lauchokyip/ece477grp4/README.md

# ece477grp4 - Virtual Queue
## Team members
* [Nathan Pietraszak](https://github.com/natepzak) (Team Lead)
* [Aidan Connor Roy](https://github.com/aidanroy0) (Hardware Lead)
* [Devansh Rathi](https://github.com/DevanshRathi1) (Software Lead)
* [Chok Yip Lau](https://github.com/lauchokyip) (Systems Lead)

## Web Server
* [link](https://virtualqueue477.herokuapp.com/) to the web server
  
## User manual 
* [link](UserManual.pdf) to the user manual

### Homework 
* [Functional Specification](HW/ECE477HW2.pdf)
* [Software Overview](HW/ECE477HW3.pdf)
* [Component Analysis](HW/ECE477HW4.pdf)
* [Bill of Materials](HW/ECE477HW5.pdf)
* [Electrical Overview](HW/ECE477HW6.pdf)
* [Mechanical Overview](HW/ECE477HW7.pdf)
* [Software Formalization](HW/ECE477HW8.pdf)

### STM32L4 Documentation
* [Programming Manual](programmingManual.pdf)
* [Reference Manual](referenceManual.pdf)

### References
* [STM32L4 Documentation website](https://www.st.com/en/microcontrollers-microprocessors/stm32l476vg.html#documentation)
* [Datasheet for Wifi Module (ESP8266)](refs/ESP8266_Specifications_English.pdf)
* [Datasheet for Motion Detection Sensor (AK9753)](refs/AK9753.pdf)
* [Datasheet for Barcode Scanner (GM65)](refs/DFR0660.pdf)
* [Datasheet for LED Display (YX700WV03)](refs/adafruit_SPEC-YX700WV03_REV.A-787880.pdf)
* [Datasheet for Display Driver (RA8875)](refs/RA8875_DS_V19_Eng.pdf)
* [Datasheet for Battery (ICR18650)](refs/C450_-_ICR18650_6600mAh_3.7V_20140729.pdf)
* [Datasheet for Thermopile (TS305-11C55)](refs/ENG_DS_TS305-11C55_A.pdf)
* [Datasheet for Class-D Amplifier (PAM8302A)](refs/PAM8302A.pdf)
* [Datasheet for Speaker (CES-30207-158L120-67)](refs/ces_30207_158l120_67-1860391.pdf)
* [Datasheet for Low Battery Indicator IC (BD46335G-TR)](refs/bd45xxg-e.pdf)
* [Datasheet for Step-Up Voltage Converter (MAX8815A-1516131)](refs/MAX8815A-1516131.pdf)
* [Datasheet for Step-Down Voltage Converter (MAX8815A-1516131)](refs/tps62080a.pdf)
