lauchokyip/ece477grp4/HW/schematic_draft_v1.sch

## EAGLE design HW/schematic_draft_v1.sch (2021-04-16)

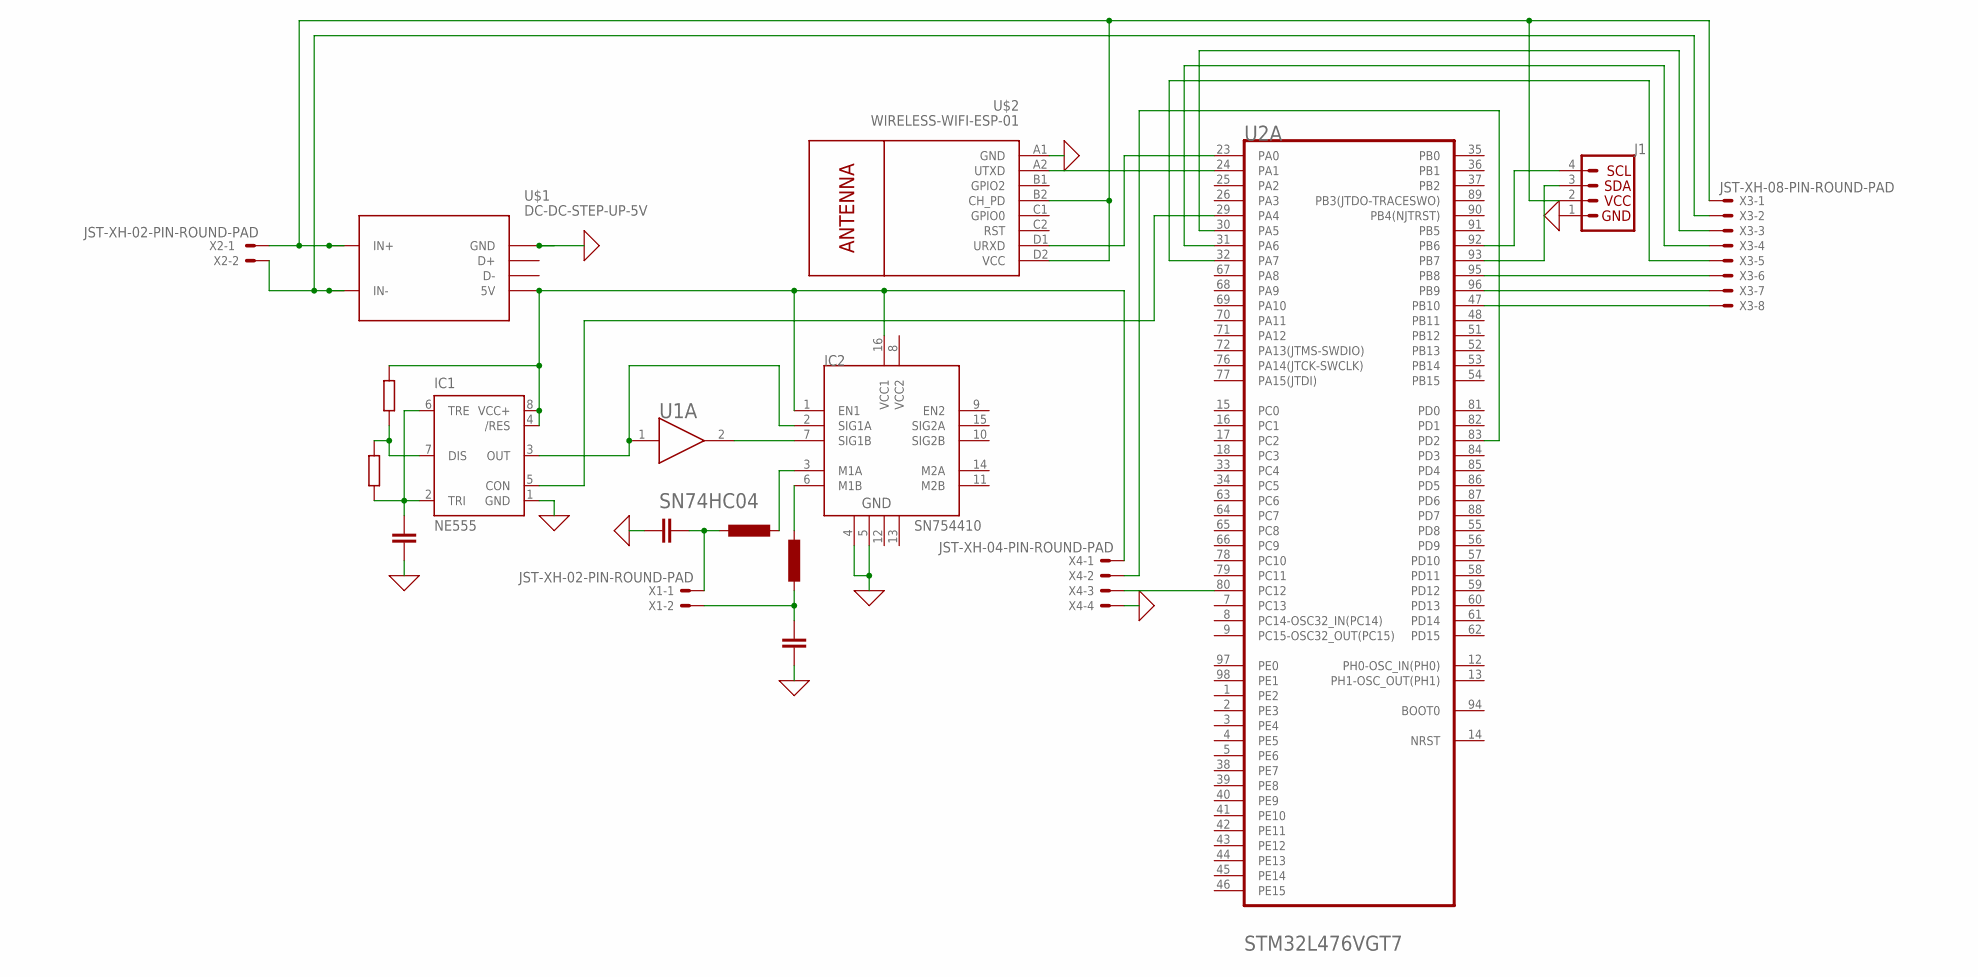
[picture p20: schematic schematic_draft_v1.sch]

Parts:
IC1: NE555; DIL-08
IC2: SN754410; DIP16
J1: QWIIC_CONNECTORJS-1MM; 1X04_1MM_RA
U1: TEXAS_INSTRUMENTS_SN74HC04TEXAS_INSTRUMENTS_SN74H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; TEXAS_INSTRUMENTS_SN74HC04_0
U2: STMICROELECTRONICS_STM32L476VGT7STMICROELECTRONIC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; STMICROELECTRONICS_STM32L476VGT7_0
U$1: DC-DC-STEP-UP-5V
U$2: WIRELESS-WIFI-ESP-01
X1, X2: JST-XH-02-PIN-ROUND-PAD; JST-XH-02-PACKAGE-ROUND-PAD
X3: JST-XH-08-PIN-ROUND-PAD; JST-XH-08-PACKAGE-ROUND-PAD
X4: JST-XH-04-PIN-ROUND-PAD; JST-XH-04-PACKAGE-ROUND-PAD

Connections:
0: IC1.1 (GND), IC2.4, IC2.5, J1.1 (GND), U$1.GND, U$2.A1 (GND), X4.4
unnamed: U2.80 (PC12), X4.3
unnamed: J1.2 (VCC), U$1.IN+, U$2.B2 (CH_PD), U$2.D2 (VCC), X2.1, X3.1
unnamed: U$1.IN-, X2.2, X3.2
unnamed: IC1.2 (TRI), IC1.6 (TRE)
unnamed: J1.4 (SCL), U2.92 (PB6)
unnamed: IC2.7 (SIG1B), U1.2 (!1Y!)
unnamed: IC1.3 (OUT), IC2.2 (SIG1A), U1.1 (1A)
unnamed: U2.24 (PA1), U$2.A2 (UTXD)
unnamed: U2.23 (PA0), U$2.D1 (URXD)
unnamed: IC1.4 (/RES), IC1.8 (VCC+), IC2.1 (EN1), IC2.16 (VCC1), U$1.5V, X4.1
unnamed: J1.3 (SDA), U2.93 (PB7)
unnamed: IC1.5 (CON), U2.29 (PA4)
unnamed: U2.83 (PD2), X4.2
unnamed: U2.30 (PA5), X3.3
unnamed: U2.31 (PA6), X3.4
unnamed: U2.32 (PA7), X3.5
unnamed: U2.95 (PB8), X3.6
unnamed: U2.96 (PB9), X3.7
unnamed: U2.47 (PB10), X3.8
