lauchokyip/ece477grp4/VirtualQueue/Src/main.c

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

/* Includes ------------------------------------------------------------------*/
#include "main.h"

/* USER CODE BEGIN Includes */
#include <stdio.h>
//#include "retarget.h"
#include "utility.h"
#include "wifi_module.h"
#include "qr_scanner.h"
#include "motion.h"
#include "mytype.h"
#include "thermopile.h"
/* USER CODE END Includes */

ADC_HandleTypeDef hadc1;
ADC_HandleTypeDef hadc2;

I2C_HandleTypeDef hi2c1;

LCD_HandleTypeDef hlcd;

SPI_HandleTypeDef hspi1;

TIM_HandleTypeDef htim16;
TIM_HandleTypeDef htim17;

UART_HandleTypeDef huart4;
UART_HandleTypeDef huart2;
DMA_HandleTypeDef hdma_uart4_rx;

void SystemClock_Config(void);
static void MX_GPIO_Init(void);
static void MX_DMA_Init(void);
static void MX_LCD_Init(void);
static void MX_USART2_UART_Init(void);
static void MX_UART4_Init(void);
static void MX_SPI1_Init(void);
static void MX_TIM16_Init(void);
static void MX_ADC1_Init(void);
static void MX_ADC2_Init(void);
static void MX_I2C1_Init(void);
static void MX_TIM17_Init(void);
/**
  * @brief  The application entry point.
  * @retval int
  */
int main(void)
{
  /* MCU Configuration--------------------------------------------------------*/

  /* Reset of all peripherals, Initializes the Flash interface and the Systick. */
  HAL_Init();

  /* USER CODE BEGIN Init */
  BSP_LCD_GLASS_Init();

  /* USER CODE END Init */

  /* Configure the system clock */
  SystemClock_Config();

  /* Initialize all configured peripherals */
  MX_GPIO_Init();
  MX_DMA_Init();
  MX_LCD_Init();
  MX_USART2_UART_Init();
  MX_UART4_Init();
  MX_SPI1_Init();
  MX_TIM16_Init();
  MX_ADC1_Init();
  MX_ADC2_Init();
  MX_I2C1_Init();
  MX_TIM17_Init();
  /* USER CODE BEGIN 2 */
  //RetargetInit(&huart2);
  printf("\r\nStarting\r\n");

  // INITS
  queue_length = 0; // init these first so the display works
  store_capacity = 0;
  num_in_store = 0;

  qr_scanner_init(&huart2, 0); // note - THIS SHOULD BE CALLED BEFORE esp8266_init() if using QR scanning for WiFi setup

  bool esp_ok = esp8266_init(&huart4, &hspi1, 1, 0);
  if (esp_ok == false) {
	  //main_display_info(&hspi1, num_in_store, queue_length, store_capacity, "Wifi doesn't set up properly", NULL, NULL, NULL);
	  return 1;
  }

  //main_display_init(&hspi1);
  main_display_info(&hspi1, num_in_store, queue_length, store_capacity, "Starting up...", "Please wait", NULL, NULL);

  qr_scan_pending = 0;
  HAL_UART_Receive_IT(qr_huart, qr_buf, QR_SIZE); // note - CALL THIS HERE to restart QR scanning after WiFi setup via QR

  thermopile_init(&hadc1, &hadc2);

  bool motion_sensor_ok = initialize_motion_sensor(&hi2c1);
  if (motion_sensor_ok != true) {
	  main_display_info(&hspi1, num_in_store, queue_length, store_capacity, "motion sensor fails", NULL, NULL, NULL);
	  return 1;
  }


  // MOTION SENSOR BUFFER VARIABLES
  int pir_size = 50; // size of buffer
  int pir_samples[pir_size]; // buffer
  int threshold = 5; // number of readings in buffer to trigger motion
  int left = 0; // number of lefts
  int right = 0; // number of rights
  int nothing = pir_size; // number of no motions
  bool send_enable = false; // flag to prevent constantly sending when threshold met
  int sample_i = 0; // sample index
  for(; sample_i < pir_size; ++sample_i) {
	  pir_samples[sample_i] = 0;
  }
  sample_i = 0;

  printf("INIT DONE\r\n");
  main_display_info(&hspi1, num_in_store, queue_length, store_capacity, "Setup complete!", NULL, NULL, NULL);
  //get_status(); // get initial queue status for monitor
  HAL_TIM_Base_Start_IT(&htim16);
  HAL_TIM_Base_Start_IT(&htim17);

  int prevent_strobe = 0;
  /* USER CODE END 2 */

  /* Infinite loop */
  /* USER CODE BEGIN WHILE */
  while (1)
  {

    // QR HANDLING
    // if a qr scan has OCCURRED, handle
	if (qr_scan_pending == 1) {
		printf("BEGIN SEND SCAN\r\n");
		qr_scan_received();
	}

    // MOTION SENSOR HANDLING
	if (loop_motion_sensor(&hi2c1) == true) {
		uint8_t movement = motion_sensor_get_moment();

        // decrement count of motion type that is being overwritten
		if (pir_samples[sample_i] == 1) {
			--right;
		} else if (pir_samples[sample_i] == -1) {
			--left;
		} else {
			--nothing;
		}

        // increase appropriate motion type count
		if (movement & MOVEMENT_FROM_2_TO_4)
	    {
		  // RIGHT
	      pir_samples[sample_i] = 1;
	      ++right;
	    }
	    else if(movement & MOVEMENT_FROM_4_TO_2)
	    {
	      // LEFT
	      pir_samples[sample_i] = -1;
	      ++left;
	    } else {
	      pir_samples[sample_i] = 0;
	      ++nothing;
	    }

		if (sample_i % 10 == 0) {
			printf("left: %d    right: %d    nothing: %d\r\n", left, right, nothing);
			if (nothing != pir_size) {
				int i;
				for (i = 0; i < pir_size; ++i) {
					printf("%d ", pir_samples[i]);
				}
				printf("\r\n");
			}
		}

        // increment buffer index
		sample_i++;
		if (sample_i >= pir_size) {
			sample_i = 0;
		}

        // if motion type has exceeded threshold and able to send,
        // send that type and disable sending
		if (left > threshold && send_enable) {
			printf("SEND LEFT\r\n");
			if (valid_entries > 0) {
				send_entry();
				--valid_entries;
				main_display_info(&hspi1, num_in_store, queue_length, store_capacity, "     Welcome to the ABC Store!", "Please wait to enter...", NULL, NULL);
			} else {
				send_unauthorizedEntry();
				main_display_info(&hspi1, num_in_store, queue_length, store_capacity, "WARNING:", "UNAUTHORIZED ENTRY", NULL, NULL);
			}
			send_enable = false;
		} else if (right > threshold && send_enable) {
			printf("SEND RIGHT\r\n");
			send_exit();
			send_enable = false;
			main_display_info(&hspi1, num_in_store, queue_length, store_capacity, "     Welcome to the ABC Store!", "Please wait to enter...", NULL, NULL);
		} else if (right < threshold && left < threshold) {
            // if both motion types below threshold, enable sending
			if (!send_enable) {
				printf("SEND ENABLE\r\n");
				send_enable = true;
				main_display_info(&hspi1, num_in_store, queue_length, store_capacity, "     Welcome to the ABC Store!", NULL, NULL, NULL);
			}
		}
	}

    // WIFI HANDLING
    // if have a response to handle
	if (message_pending_handling == 1) {
		handle_message_response();
	}
    // if messages pending, get ok and then send
	if (message_queue_head != NULL) {
		if (ready_for_next_message == 1) {
			tcp_connect();
		} else if (good_to_get_ok == 1) {
			get_ok_to_send();
		} else if (good_for_send == 1) {
			send_message();
		}
	}

	// TEMPERATURE
	if (people_checking_in > 0) {
		printf("CHECKING IN\r\n");
		if (prevent_strobe == 0) {
			main_display_info(&hspi1, num_in_store, queue_length, store_capacity, "     Welcome!", "Place your forehead near the sensor", "at the top of the kiosk", NULL);
			HAL_Delay(3000);
			prevent_strobe = 1;
		}
		/*
		//temeprature test
		while(1){
			int temp = getTemp();
			char temp_str[4];
			sprintf(temp_str, "%d", temp);

//purposeful Tsen manipulation
			int Tsen = getTsen();
			Tsen = 30;
			char temp_str2[4];
			sprintf(temp_str2, "%d", Tsen);

			int thermopileV = getV();
			char temp_str3[4];
			sprintf(temp_str3, "%d", thermopileV);

			int Rsen = getR();
			char temp_str4[4];
			sprintf(temp_str4, "%d", Rsen);

			HAL_Delay(2000);
			main_display_info(&hspi1, num_in_store, queue_length, store_capacity, temp_str,temp_str2 , temp_str3, temp_str4);
		}
		//end temperature test
		*/

		//stores temperature values
		int temp = getTemp();
		int tsen = getTsen();
		int rsen = getR();
		int vol = getV();

		//temp = 36;
		char temp_str[4];
		sprintf(temp_str, "%d", temp);
		if (temp > TEMP_MAX) { // fever
			printf("TEMPERATURE TOO HIGH\r\n");
			main_display_info(&hspi1, num_in_store, queue_length, store_capacity, temp_str, "TEMPERATURE IS TOO HIGH", "SEEK STAFF ASSISTANCE", NULL);
			send_tempError(temp);
			people_checking_in = 0;
			prevent_strobe = 0;
		} else if (temp >= TEMP_MIN){ // in bounds
			printf("TEMPERATURE OK PLEASE ENTER\r\n");
			main_display_info(&hspi1, num_in_store, queue_length, store_capacity, temp_str, "Temperature check ok!", "Enter when ready", NULL);
			HAL_Delay(1000);
			++valid_entries;
			--people_checking_in;
			prevent_strobe = 0;
		}
		if (people_checking_in == 0) {
			send_doneCheckingIn();
			prevent_strobe = 0;
		}
	}

	/*
	if (got_unexpected == 1) {
		int z;
		for (z = 0; z < 500; ++z) {
		  printf("%d ", unexpected_return[z]);
		}
		got_unexpected = 0;
	}
	*/


    /* USER CODE END WHILE */

    /* USER CODE BEGIN 3 */
  }
  /* USER CODE END 3 */
}

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
/* USER CODE BEGIN 4 */

// Only used for QR callback.
// If triggered, a QR code has been scanned, set flag.
void HAL_UART_RxCpltCallback(UART_HandleTypeDef *huart)
{
	printf("RX CPLT CALLBACK\r\n");
	if (huart == qr_huart) {
		printf("QR INT\r\n");
		qr_scan_pending = 1;
	}
}

// Called when timer is up.
void HAL_TIM_PeriodElapsedCallback(TIM_HandleTypeDef *htim)
{
    // if is display status timer, get status
	if (htim == &htim16 ) {
		printf("GETTING STATUS\r\n");
		get_status();
	} else if (htim == &htim17) {
		if (message_queue_head != NULL) {
			if (advanced_wifi_state == 0) {
				advanced_wifi_state = 1;
			} else {
				abort_message();
			}
		}
	}
}

/* USER CODE END 4 */
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
