lauchokyip/ece477grp4/VirtualQueue/VirtualQueue.ioc

Mcu.UserName=STM32L476VGTx
PA0.Signal=UART4_TX
PA1.Signal=UART4_RX
PA2.Signal=ADCx_IN7
PA3.Signal=USART2_RX
PA5.Signal=ADCx_IN10
PA8.Signal=LCD_COM0
PA9.Signal=LCD_COM1
PB2.Signal=GPIO_Output
PB6.Signal=I2C1_SCL
PB7.Signal=I2C1_SDA
PC3.Signal=LCD_VLCD
PD5.Signal=USART2_TX
PE10.GPIO_Label=SPI_RST
PE10.Signal=GPIO_Output
PE12.GPIO_Label=CS
PE12.Signal=GPIO_Output
PE13.Signal=SPI1_SCK
PE14.Signal=SPI1_MISO
PE15.Signal=SPI1_MOSI
