lauchokyip/ece477grp4/VirtualQueue/Inc/main.h

#define SPI_RST_Pin GPIO_PIN_10
#define SPI_RST_GPIO_Port GPIOE
#define CS_Pin GPIO_PIN_12
#define CS_GPIO_Port GPIOE
