lauchokyip/ece477grp4/(commit log)

2021-02-04 Updated README and Added mount and umount script
2021-02-08 Imported on-board display driver Finished parsing JSON and provided examples Added links to reference manual Added Project folder
2021-02-10 SMAT Week 4
    Created flashing led and hello world code, also changed code generation setting
2021-02-11 LED in main (PB2)
    Setup for Aidan
2021-02-16 wifi uart work - unfinished
2021-02-18 Basic comm. w/ ESP8266 on UART
    only sends 1 message and gets ack
2021-02-24 ADC works
    still printing values to lcd screen onboard
2021-02-25 print to console using usart 2 working
2021-03-29 QR Scanner + UART Handle fixes
    Added QR code to src and inc, started working on sending to website (currently gets to proper int branch but unknown after than), adjusted uart handles in modules to be pointers
    [VirtualQueue.ioc, add_to_queue_hardcoded.c, main.c, scan_qr_into_queue.c, wifi_module.c, wifi_module.h]
2021-04-07 Check In Process
    WiFi UART now uses DMA to work with IDLE properly
2021-04-08 QR scan to set up WiFi
    Can now set up Wifi network name and password via a QR scan when device powers up
2021-04-08 Add entry/exit funcs, modify msg queue, start pir
    Added functions to add entry and exit GETs to the queue. Moved response validation checks inside interrupt to prevent missing the real response before restarting UART DMA. Started adding PIR to use to detect when to send entry/exit.
    [VirtualQueue.ioc, main.c, motion.c, motion.h, wifi_module.c, wifi_module.h]
2021-04-14 quick index bound fix
    had > instead of >= oops
    [main.c, main_wip.c]
2021-04-15 Added error checking & output to display
    [main_wip.c, wifi_module.c, wifi_module.h]
2021-04-16 Cleaned up README
    [schematic_draft_v1.sch]
2021-04-19 update tempError endpoint
    updated calling tempError to pass temperature as an additional parameter
